adman234/goews-rebuilt-openscad/README.md

# GOEWS rebuilt in OpenSCAD

This is a rebuild of [GOEWS](https://goews.ws/) in OpenSCAD to allow for easy
generation and customization of parts. It requires the
[BOSL2](https://github.com/BelfrySCAD/BOSL2) library and
[Gridfinity Rebuilt in OpenSCAD](https://github.com/kennetek/gridfinity-rebuilt-openscad)
installed in the library path.

It also introduces a variant with thicker cleats which improves the weight capacity of
the tiles by 60%.

## Supported parts

### Tiles

Arbitrary tiles of any size, both hex and grid, can be generated. Within the tiles
units can be removed using a skip list to work around obstacles such as electrical
receptables.

The tile mounting holes can be adjusted as well to accomodate different screw sizes and
types. Setting the countersink to 0 allows for flat screws to be used. This is
particularly useful to account for when anchors are not perfectly aligned avoiding
having to make new holes in your wall.

For hex tiles any tile edge can be optionally filled in. This is particularly useful
for the top edge as it adds additional mounting holes that are more likely to hit a top
plate on a standard drywall-covered wall.

#### Thicker cleats

The thicker cleats variant can hold 60% more weight when used without the threaded
bolts. As a side-effect, the tiles actually use about 14% less filament and no longer
have sharp edges.

From testing, the original cleats, without bolts, held at 25lb and failed at 30lb. The
thicker cleats held at 40lb and failed at 45lb.

#### Tile stacks

Tile stacks allow multiple tiles to be printed in a single job by alternating normal
tile geometry with thin separator layers. The intended use is to print the tiles in
PLA and the separators in PETG, taking advantage of the poor adhesion between those
materials so the finished stack can be separated after printing.

This requires a multi-material printer, toolchanger, or filament changer capable of
printing PLA and PETG in the same job. Examples include toolchanger printers such as
the [Snapmaker U1](https://www.snapmaker.com/en-CA/snapmaker-u1), multi-material
systems such as the [Sovol M1D](https://www.sovol3d.com/pages/sovol-m1d-landing-page),
or community filament changers such as the
[Enraged Rabbit Project](https://github.com/EtteGit/EnragedRabbitProject) or [BoxTurtle Project](https://github.com/ArmoredTurtle/BoxTurtle)  for
Voron/Klipper-style printers.

In the web generator, tile stacks are available under **Tiles** as **Tile Stack**.
The generator supports both hex and grid tiles, a configurable stack count, and the
same tile sizing and mounting-hole options as the normal tile generators. The browser
preview shows the tile bodies and separator layers as separate materials.

When downloading a tile stack from the web generator, the download is a ZIP file
containing two STL files:

* `tile-stack-*.stl` — the tile bodies and any PLA support geometry
* `tile-stack-*-spacers.stl` — the PETG separator layers and pull tabs

Import both STLs into the slicer together as one multi-part object, keeping their
relative positions unchanged. Assign the tile body STL to PLA and the spacer STL to
PETG.

In OrcaSlicer, enable multi-material printing, assign PLA and PETG to the two imported
parts, then enable **Print Settings → Multimaterial → Advanced → Interface Shells**.
This ensures solid layers are generated between the tile bodies and the separator
layers. Do not enable interlocking beams for this use case; the goal is for the PLA and
PETG layers to release from each other after printing, not to bond more strongly.

### Hooks

Hooks are similar to the original ones. The shank and post dimensions are
configurable.

### Racks

Racks are a new type of part that can be used for hanging items with wide tops. This is
quite useful for storing cables, bar clamps, screwdrivers, etc.

### Shelves

Shelves can be generated with any width and depth. There are variants with holes,
slots, and Gridfinity bases as well.

### Bins

Bins are simple square bins with customizable width, depth, and height.

### Cups

Cups are simple cups with customizable inner diameter and height.

### Hanger mounts

Hanger mounts allow you to mount almost anything to GOEWS.

Holes can be placed at any position on the plate, which can be made thicker to account
for the hardware. The holes can be made for heat-set inserts, self-tapping screws, hex
nuts or bolts, sqare nuts, socket and button cap screws, and flat countersink screws.

### Cable clips

Cable clips are useful for organizing cables. Plates with multiple clips are supported
and clips can be made to hold single or multiple cables.

### Bolts

Bolts are similar to the original ones. The length and socket width are configurable.

## Part generator

A part generator is included that provides a web interface to generate the supported
parts. The `openscad` command must be available in the `PATH` for the user running the
server and BOSL2 must be available in the library path.

To run it locally in dev mode:

```bash
make serve
```

The application will be available at http://localhost:5173/

To build for production:

```bash
make server
```

### Running it in Docker

The easiest way to host the generator yourself is with Docker. The image includes
the OpenSCAD nightly (with the fast Manifold backend), BOSL2, the built frontend
and the server:

```bash
docker compose up -d --build
```

Then open http://localhost:8000/. To use a different port, change the left side of
`ports` in `docker-compose.yml` (for example `"8080:8000"`).

The tile stack's **Download ZIP** contains:

- a 3MF with the PLA tiles and PETG separators as one object, with the filaments
  already assigned (PLA = filament 1, PETG = filament 2)
- STLs of the tiles and of the separators
- a STEP file of the separators, if **Include Step** is ticked (this adds a minute
  or so for large stacks)

STEP export uses OpenCascade, which adds about 300 MB to the image. To leave it
out, set `WITH_STEP: "false"` in `docker-compose.yml` and rebuild.

To update after pulling new changes:

```bash
docker compose up -d --build
```

### Running it on Unraid

A GitHub Actions workflow publishes the image to
`ghcr.io/adman234/goews-rebuilt-openscad:latest` on every push to the
`docker-local` branch. To install it, download the template on the Unraid server
(terminal or SSH):

```bash
wget -O /boot/config/plugins/dockerMan/templates-user/my-goews-generator.xml https://raw.githubusercontent.com/adman234/goews-rebuilt-openscad/docker-local/unraid/goews-generator.xml
```

Then in the Unraid web UI go to **Docker → Add Container**, pick
**goews-generator** from the **Template** list, and click **Apply**. The web UI is
on port 8000 by default.

There is Systemd unit definition in `systemd/goews.service`. It assumes the location of
this repo is checked out at `/srv/goews-rebuilt-openscad` and a user `goews` exists.
For security reasons, it is highly recommended that nothing under the checkout is
actually writable by the `goews` user.

## TODO

PRs and suggestions are welcome :-)

* Shelf supports
* Bins with dividers
* Multi-cups
* Optional multiple vertical hangers for taller items
